thuningxu/my-chip/README.md

# my-chip

A hill-climbing project on matrix-multiply hardware, using open-source EDA
(Yosys + OpenROAD via ORFS) on the Nangate45 academic PDK.

The deliverable is **not** the chip. It is `EXPERIMENTS.md` — a table of
measured, reproducible rows where every row is one idea, and every number says
what kind of number it is.

Four designs live here, selected with `DESIGN=`:

| design | what | scale |
|---|---|---|
| **`mac_array`** (default) | INT4 outer-product MAC array. The v0 baseline, deliberately the simplest *correct* design. `D = init + A@B` with three init modes and two readout modes | 16 mult at N=4, 256 at N=16 |
| **`amx_tdpbssd`** | **Intel AMX `TDPBSSD`** — INT8 tile dot-product, `C += A@B` on `(16,64)@(64,16)`, 16,384 MACs, with optional INT32 saturation | 1024 mult, 16 cycles |
| **`tpu_mmu`** | **TPU v1-style weight-stationary systolic array** — `C += A@W`, N×N, INT8. Built at `TN=32` because 32×32 = 1024 multipliers is *exactly* `amx_tdpbssd`'s count, which makes systolic-vs-broadcast a controlled comparison rather than one across scales | 1024 mult at TN=32, 3N cycles |
| **`amx_fp8`** | **Intel AMX-FP8** (Diamond Rapids) — all four mix-and-match variants (`TDPBF8PS`/`TDPBHF8PS`/`TDPHBF8PS`/`TDPHF8PS`) in one netlist, selected at *runtime* by `op[1:0]`. `C += A@B` on `(16,64)@(64,16)`, fp8 in, **IEEE FP32 accumulate**. Same operand delivery as `amx_tdpbssd`, so the delta is purely the arithmetic. `PIPE=1` registers the product to get the operand mux and the multiply out of the accumulate loop | 1024 mult + **1024 FP32 adders**, 20+`PIPE` cycles |

```bash
make sim-matrix                          # all designs, all parameter states (46)
make measure DESIGN=amx_tdpbssd SAT=1    # synth + P&R one of them
make measure DESIGN=tpu_mmu TN=32 RDREG=1
make measure DESIGN=amx_fp8 RDREG=1 PIPE=1
```

## Prerequisites

| Dependency | Why | Minimum |
|---|---|---|
| Homebrew + Xcode CLT | installing everything else (macOS) | — |
| **Icarus Verilog** | simulation. `measure.sh` refuses to emit PPA without a passing sim | 12.0 |
| **Python 3** | golden model, QoR extraction | 3.8 |
| **Yosys** | synthesis | **0.58** (ORFS minimum) |
| **ORFS** with a built `openroad` | synthesis + place & route + STA | any recent — **see [SETUP.md](SETUP.md)** |
| **KLayout** | GDS merge — and ORFS calls `klayout -v` at makefile **parse** time | 0.28.8 |
| Nangate45 PDK | the standard cells; ships inside ORFS | — |

## Quick start

**On a brand-new machine, start with [SETUP.md](SETUP.md)** — it covers cloning
and building ORFS, which `setup.sh` requires but does not do. On macOS that is
the bulk of the work: ORFS's own `build_openroad.sh --local` does not work there,
and SETUP.md has the manual recipe.

Once ORFS exists and `openroad` runs:

```bash
./setup.sh          # check + install what's missing, write local.mk
make sim            # run the regression       (22/22 must pass)
make measure        # sim-gated synth + P&R, prints one QoR row
make path           # why the clock is what it is
```

`setup.sh` discovers ORFS automatically (`$ORFS`, `../OpenROAD-flow-scripts`,
`~/sd/...`), verifies the `openroad` binary actually runs, checks the Yosys
version against ORFS's 0.58 floor, and resolves a KLayout that **provably
answers `-v`** — auto-creating a de-quarantined copy on macOS if the
`/Applications` one hangs. It writes `local.mk` so no target needs exported
variables. Use `./setup.sh --check` to verify without installing anything.

```bash
make help                       # all targets + resolved tool paths
make sim N=8                    # regression at another array size
make sim-all                    # N = 4, 8, 16
make sim-matrix                 # N x C_PORT x OUT_PAR -- all 12 configurations
make sim OUTPAR=1               # parallel readout: 8 cycles instead of 23
make golden                     # Python reference model
make measure N=8 PERIOD=1.4     # override anything
make sweep-period               # 1.6 / 1.4 / 1.2 / 1.0 ns
make sweep-n                    # N = 4, 8, 16
make clean                      # local artifacts (ORFS results untouched)
```

**`measure.sh` will not produce a PPA number unless the regression passes.**
That gate is the point of the script.

## Layout

```
my-chip/
├── setup.sh             # dependency check/install -> writes local.mk
├── Makefile             # sim / measure / sweep / clean targets
├── local.mk             # generated, gitignored, machine-specific tool paths
├── rtl/mac_array.v      # v0 baseline: parameterised N x N INT4 outer-product MAC
├── rtl/amx_tdpbssd.v    # Intel AMX TDPBSSD, 1024 INT8 MACs, broadcast array
├── rtl/tpu_mmu.v        # TPU v1-style weight-stationary systolic array
├── rtl/amx_fp8.v        # Intel AMX-FP8, all four variants in one netlist
├── rtl/fp8_mul.v        # fp8_dec + fp8_mul -- E5M2/E4M3 decode, exact 4x4 product
├── rtl/fp32_add.v       # IEEE FP32 adder, RNE + DAZ/FTZ. 1024 instances, THE floor
├── tb/tb_mac_array.v    # self-checking regression, 22 cases, PASS at N=4/8/16
├── tb/tb_fp32_add.v     # 121k checks on the adder -- ties, cancellation, DAZ/FTZ
├── tb/tb_fp8_mul.v      # EXHAUSTIVE: all 4 format pairs x 256 x 256
├── tb/golden.py         # independent Python reference + accumulator-width checker
├── tb/amx_golden.py     # 4th model for TDPBSSD: VNNI pack/unpack, both SAT modes
├── tb/tpu_golden.py     # cycle-accurate systolic model + the SCHEDULE PROOF
├── tb/fp8_golden.py     # two independent FP32 adders + an exact rational yardstick
├── flow/nangate45/
│   ├── config.mk.in     # ORFS config TEMPLATE -- the single definition
│   └── constraint.sdc.in# SDC TEMPLATE. Edit these; never the generated copies.
├── scripts/measure.sh   # sim gate -> stage -> ORFS -> QoR row
├── EXPERIMENTS.md       # the log. This is the actual output of the project.
└── work/                # ALL generated output, gitignored
    ├── designs/         #   generated per-N config.mk + constraint.sdc
    ├── results/         #   .odb / .def / .gds / netlists
    ├── reports/         #   layout images (*.webp), DRC report
    ├── logs/            #   per-stage logs + 6_report.json metrics
    └── objects/
```

### Nothing is written into the ORFS checkout

`measure.sh` passes ORFS two variables so the third-party clone stays pristine
and this repo owns its own artifacts:

| Variable | Set to | Effect |
|---|---|---|
| `WORK_HOME` | `my-chip/work` | redirects `LOG_DIR`, `OBJECTS_DIR`, `REPORTS_DIR`, `RESULTS_DIR` (`variables.mk:46-49`) |
| `DESIGN_HOME` | `my-chip/work/designs` | relocates the design tree (`variables.mk:13`) |

ORFS defaults `WORK_HOME ?= .` (`Makefile:98`), which is `$ORFS/flow` when you
run make from there — that is why an unconfigured flow scatters your results
across someone else's repo, where `git clean` or an ORFS update will eat them.
`VERILOG_FILES` points straight at this repo's `rtl/`, so the RTL is never
copied either.

Verified: relocating produced a byte-identical QoR row, and
`$ORFS/flow/{results,logs,reports,objects,designs}` contain no `my_chip_*`
entries.

## What the design computes

**Two names, one convention.** `A`/`B` are the mathematical matrices, indexed
`[row][col]`. `Amem`/`Bmem` are what the two memories hold, indexed `[k][lane]` —
literally what `act_rdata` and `wgt_rdata` deliver, one word of `N` signed INT4
lanes per `k`. The required layout is:

| | holds | so | |
|---|---|---|---|
| `Amem[k]` | **column** k of A | `Amem = Aᵀ` | **A is stored transposed** |
| `Bmem[k]` | **row** k of B | `Bmem = B` | B is not |

In terms of what the ports see, and then what it means:

```
D[i][j] = init[i][j] + sum over k of  Amem[k][i] * Bmem[k][j]   for k in [0, k_dim)
        = init[i][j] + sum over k of     A[i][k] *    B[k][j]
   D    = init + A@B
```

`init` is selected by `init_mode`: `INIT_ZERO` (D = A@B), `INIT_C`
(D = A@B + C, C supplied on `c_in`), or `INIT_KEEP` (D = A@B + D_prev, which
chains k-tiles with no reset). Verified against a textbook triple loop in tb
cases M1/M2.

**Why only A is transposed, and why that isn't a design choice.** In
`C[i][j] = Σ_k A[i][k]·B[k][j]` the contraction index `k` is A's *column* index
and B's *row* index, so any dataflow iterating over `k` must walk A column-wise
and B row-wise. The asymmetry is in the definition of matrix multiplication, not
in this implementation. What varies is which slices you take — an inner-product
array takes row `i` of A against column `j` of B per output; this one is
outer-product, taking column `k` of A against row `k` of B per *cycle* and
accumulating a rank-1 update, `A@B = Σ_k (col_k A)(row_k B)`. That is why one
cycle touches all `N²` accumulators instead of finishing one output.

So there is no transpose *hardware* — the transpose is **relocated** to whoever
fills the memories, where gathering `Amem[k]` is a strided read of A and
`Bmem[k]` is contiguous. Free in gates, not free in data prep.

Measured cost of the addend (yosys generic synth, N=4, total cells): chaining is
free (4937 -> 4935), external C costs +381 cells and is entirely the data mux
(one ACC_W-wide 2:1 mux per accumulator). Build with `C_PORT=0` to drop it.

`A[k]` and `B[k]` are each `N` signed INT4 lanes packed into one memory word.
The block masters two read ports and one write port. `N` is a parameter (power
of two) — sweep it with `measure.sh -n`.

**How results come out is a parameter too, and it decides the cycle count.**
`OUT_PAR=0` (default) drains one element per cycle through an `N*N:1` mux;
`OUT_PAR=1` presents all `N*N` accumulators at once on `out_all`. Measured cycle
counts fit exactly across 20 cases with K from 0 to 2048:

| | cycles | K=4, N=4 | K=1024, N=4 |
|---|---|---|---|
| `OUT_PAR=0` | `K + N*N + 3` | 23 (17% of multipliers busy) | 1043 (98%) |
| `OUT_PAR=1` | `K + 4` | **8 (50%)** | 1028 (98%) |

The drain is a *fixed* cost, so it is nearly free when streaming long K and
catastrophic on the small tile a tensor core is defined by. Because it scales as
`N*N`, the speedup grows with the array: at K=4 it is 2.9× at N=4, 8.9× at N=8
and **32.9× at N=16** (263 → 8 cycles).

In *generic* synth `OUT_PAR=1` looks cheaper — −911 cells, since the serial drain
is not just a mux but two counters, an index multiply-add and an address decode,
all to move data `out_all` reaches with plain wires. **Routed, it costs +99 to
+164 stdcells instead**, because a 384-bit output port needs ~382 buffers that
generic synth does not model. The flip-flop saving is real and exact (−33), and
cell *area* does fall (−74 to −182 µm²) since flops are bigger than buffers.
Coarse-cell deltas tell you about logic, never about area — see `EXPERIMENTS.md`
rows f2a/f2b, where the same trap caught `c_in` in the other direction.

Both modes are permanent: `out_all` is `N*N*ACC_W` bits, 384 at N=4 but
**6,144 at N=16**, so the parallel readout is viable *because* a tensor-core tile
is small. Keep the serial drain for large-N streaming.

v0 is deliberately the **simplest correct** design, not a fast one: multiply and
a full 24-bit add sit in the same cycle. That is the first thing to fix, and the
baseline you measure against.

## Discipline this repo enforces

Each of these exists because its absence caused a real, documented failure in a
prior project of this kind:

| Rule | Failure it prevents |
|---|---|
| `measure.sh` gates PPA on a passing sim | a published headline frequency for a design that computed `2*sum - last` instead of a dot product, because *it was never simulated* |
| T1 (all-ones, K=4) is permanent | that same double-accumulate bug — it shows up as `5` (or `7`) instead of `4` |
| T6 (restart with no reset) is permanent | `DONE` as a terminal state: first operation works, every later `start` silently ignored |
| T5 (adversarial K) + `golden.py --acc-w` | a 12-bit accumulator claimed safe to K=64 that actually overflows at K=32 |
| The config exists once, as a template `measure.sh` fills in | nearly every config in a comparable project hardcoded its author's home directory, unrunnable anywhere else — and a committed config nothing reads will silently drift from the one that runs |
| `measure.sh` verifies a **GDS** exists, not just metrics | reporting PPA for a flow that never finished. ORFS lists `6_report.log` before `$(GDS_FINAL_FILE)` in `finish`, so an image-renderer crash (GUI-0070) aborts make *before* the GDS rule — for many runs this repo reported routed numbers for a design it had never actually built |
| SDC always sets `set_clock_uncertainty` | omitting it flatters every reported frequency by ~10% |
| `EXPERIMENTS.md` has a `Stage` column | an ABC mapping objective (900 MHz) tabulated next to routed slack as if comparable |
| Baseline measured in *this* flow | speedups quoted against an external number that was never reproduced |
| `N` is a parameter | dozens of near-duplicate hand-copied RTL files, one per array size |
| The tb **asserts** cycle count, not just the result | an optimisation that quietly *cost* cycles while still computing the right answer. `OUT_PAR` exists to move that number, so leaving it unchecked would make the whole change unfalsifiable |
| `make sim-matrix` builds every parameter in both states | a parameter that only ever ships in one configuration is dead code with a name — `C_PORT=0` and `OUT_PAR=1` each have to compile, simulate and route |
| `nick()` is the single definition of an artifact name | `make path` reading a *different design* than `make measure` just wrote, reporting a plausible wrong critical path. Adding `OUT_PAR` to the name needed an explicit `!= "0"` test, because `${4:+...}` fires on the string `"0"` and would have renamed every existing config |

## Known gotchas already hit

- **Do not declare an output port `signed`.** Yosys preserves the attribute into
  the netlist and OpenSTA rejects it (`syntax error` on the port line). Bits are
  two's complement regardless.
- **`klayout -v` runs at makefile-parse time.** Every `make` invocation hangs if
  KLayout is quarantined. On macOS: `ditto --noextattr --norsrc` a copy, or clear
  `com.apple.quarantine`.
- **A variable-indexed 2D array read is an `N*N:1` mux.** Fine at N=4 and N=16
  (both measured; neither is limited by it), becomes the critical path around
  N=32. Pipeline the readout before scaling that far.
- **ORFS's `6_report` can fail at `GUI-0070`** (`gui::save_image` cannot find a
  display control) *after* metrics are already written. That is the image
  renderer, not the design — 9 of the 10 layout images are still produced, only
  `final_worst_path.webp` is lost. `measure.sh` tolerates that exact signature
  and hard-fails on anything else.
- **`read_db` does not restore liberty.** Load `read_liberty` first or STA gives
  you nothing but `STA-2141 No liberty libraries found`.
- **`report_checks` defaults to the worst path group**, which here is an
  asynchronous recovery check on `rst_n` — true, but a false path in the SDC and
  useless for finding the datapath limiter. Always pass `-path_group core_clock`
  (`scripts/report_path.sh` does).

## License

MIT — see [LICENSE](LICENSE).

Covers the contents of this repository only: the RTL, testbench, scripts,
templates and docs, all of which are original. It does **not** cover the tools
this project drives or the PDK it targets, none of which are vendored here:

| Not covered | Licensed separately |
|---|---|
| OpenROAD / ORFS | BSD-3-Clause |
| Yosys | ISC |
| Nangate45 PDK | its own terms — ships inside ORFS |
| Icarus Verilog | GPL-2.0 |

## Honest scope

Nangate45 is a teaching PDK with no fab target, and `measure.sh` reports the
**typical** corner only, with no signoff derating. These numbers are useful for
comparing rows in `EXPERIMENTS.md` against each other. They are not silicon
predictions, and they are not comparable to a production accelerator on a modern
node.

## Current state

All four designs are routed and DRC-clean. Frequencies are `reg→reg` — the only
kind this project compares, because a path ending at an output port is measuring the
SDC's pad convention rather than the hardware.

| design | best measured | notes |
|---|---|---|
| `mac_array` | 783 MHz at N=4, 748 at N=16 | v0 baseline. Setup not met at 1.00 ns; multiply and a 24-bit add share a cycle |
| `amx_tdpbssd` | **698.9 MHz / 2.436 W** at `PIPE=3 RD_REG=1` | X1–X4 **closed**. Limited by a multiplier carry-propagate at ~703 MHz; 1.40 ns is the knee, past which power is the cost and frequency is not the return |
| `tpu_mmu` | 3N cycles at `TN=32` | one row, systolic-vs-broadcast at matched multiplier count. **Hold is violated — not signoff-clean**, `--hold-margin` was omitted |
| `amx_fp8` | **210.5 GMAC/s**, 256.9 MHz / 14.45 W at `PIPE=1 RD_REG=1 CTRL_REG=1 CHAIN=1` | X5–X7. **+45.5%** completed throughput over X5-Y0, at initiation interval 20 and latency 20. Hold passes and DRC=0, but setup misses 3.80 ns by 92 ps; clock and throughput are STA-implied, not timing-closed |

The comparison this project exists to make: **bit-exact IEEE FP32 accumulation
costs 2.72× the throughput and 6.02× the cells of INT32 accumulation** at
identical MAC count and operand delivery. That penalty has fallen twice —
3.99×/7.48× at X5-Y0, 3.45×/6.49× after `PIPE=1`, 2.72×/6.02× after the epilogue
control register and the chained handshake. None of it came from touching the FP32
arithmetic.

Ranked on **completed resident-tile throughput**, not MHz, and the distinction
earned its keep: X7's `CHAIN` moved the clock +0.08% and throughput **+5.094%**, by
cutting the initiation interval from 21 to 20 cycles. An MHz-ranked hillclimb would
have discarded it as flat. Cycle counts differ between the designs (20 vs 21 before
`CHAIN`), so the throughput ratio is not the frequency ratio — see the correction in
`EXPERIMENTS.md`.

**One caveat on the INT8 anchor.** The 698.9 MHz figure above was measured with a
reg→reg STA query that was corrected during X6; it could admit an input-port launch,
and its routed database has since been deleted, so it is labelled rather than
re-derived. Every ratio in this section inherits that and should be read as
approximate. The `amx_fp8` rows are all post-fix and unaffected. Details in
`experiments/harness.md`.

Two campaigns of reasoning are logged separately from the rows:
`experiments/harness.md` declares each generation *before* its trials run, and
`experiments/RESULTS.md` tabulates them. `rtl/README.md` carries the measured
critical paths.
