thuningxu/my-chip/(commit log)

2026-08-28 INT4 MAC array hill-climbing project with a sim-gated measurement harness
    A parameterised N x N signed INT4 outer-product MAC array, plus the
    infrastructure to measure it honestly through Yosys + OpenROAD (ORFS) on the
    Nangate45 academic PDK.
    The deliverable is EXPERIMENTS.md -- a table of measured, reproducible rows,
    one idea per row, where every number states what kind of number it is.
    v0 is deliberately the simplest CORRECT design rather than a fast one: multiply
    and a full 24-bit add share one cycle, so there is somewhere to climb from. N is
    a parameter from the start rather than a hand-copied file per array size.
    Measured baseline (ORFS 26Q3-1510, nangate45, typical corner, both DRC-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
    [golden.py, mac_array.v, tb_mac_array.v]
2026-08-29 Add the +C addend (D = A@B + C), and the tooling to prove it
    Three strands, all measured rather than asserted.
    1. THE ADDEND. mac_array gains init_mode, selecting what the accumulators
    start from:
    INIT_ZERO D = A@B bit-identical to v0 (encoding 0, so an
    undriven port reproduces the old design)
    INIT_KEEP D = A@B + D_prev chains k-tiles, costs -2 cells
    INIT_C D = A@B + C arbitrary external C on an N*N*ACC_W port
    Also verified that the UNMODIFIED datapath already computes a matrix
    product when A is fed column-major -- no transpose hardware was needed,
    only a statement of the memory layout. Checked against an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
2026-08-29 Name the two coordinate systems: A/B vs Amem/Bmem
    "A" was being used to mean two different things, four lines apart in the same
    header, and the ambiguity had spread to five files. rtl/mac_array.v:5 wrote
    D[i][j] = sum_k A[k][i] * B[k][j]
    where "A" is the STORED array (so that expression is A-transpose times B), then
    nine lines later wrote "word k holding column k of A (lane i = A[i][k])" where
    "A" is the MATHEMATICAL matrix. golden.py picked the first convention and printed
    "C = A^T B"; README.md:107 and EXPERIMENTS.md:157 used the first, README.md:113
    the second, and rtl/README.md the first. Every one self-consistent; together,
    confusing -- and in matmul hardware a misread of which ob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
2026-08-29 Schematics: per-config output directories, and draw amx_tdpbssd too
    Two fixes, both prompted by the same observation -- that every schematic run
    wrote to one flat build/schematic/.
    1. OUTPUT IS NOW PER-CONFIGURATION, at build/schematic/<nick>/, reusing the same
    nickname the measured artifacts use so a figure set can be matched to an
    EXPERIMENTS.md row.
    The flat directory was a real defect, not a cosmetic one: `make schematic
    CPORT=0` silently overwrote the CPORT=1 set, and SN=4 overwrote SN=2, with
    nothing but the caption to say it had happened. I had added those captions
    AS the mitigation and left the collision in place. A caption is a mitigation;
    a distinct path is t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
2026-08-29 X-Y hillclimb harness + PIPE ladder, and a test gap the mutations exposed
    Sets up the Meta-Harness style outer loop for amx_tdpbssd, with Claude Code as
    the only harness. X = harness generation (how the design is reasoned about:
    which reports get read, which bottleneck gets blamed, which family of fix gets
    proposed). Y = an RTL attempt inside that generation. A Y failing implicates the
    DESIGN; a whole X row going flat implicates the HARNESS, because it kept
    proposing from the wrong family. X advances when Y stops moving.
    INFRASTRUCTURE
    experiments/harness.md append-only. X1 declared BEFORE any RTL was touched,
    including what it CANNOT reach so a plateau is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
    [amx_tdpbssd.v, tb_amx_tdpbssd.v]
2026-08-29 Add the X-Y grid reader, and fix its flat-row diagnostic
    scripts/trials.py prints the grid from experiments/trials.jsonl with the delta
    between consecutive Y, because the decision the two-axis scheme exists to support
    cannot be made from one row:
    a Y regressing or failing -> the DESIGN is wrong, try another Y
    an entire X row going FLAT -> the HARNESS is wrong; it kept proposing from
    the wrong family, so more Y cannot help
    Like trial.sh, it decides nothing. "Flat" is a threshold on a number; whether
    that means the generation is exhausted is a judgement to be made next to what
    that generation declared it could and could NOT reach.
    FLAT_MHZ is 10.0,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
2026-08-29 trial.sh: assert predictions instead of logging numbers beside them
    Acting on the second-order lesson from the X1-Y1 drift bug. The flop count was
    already being recorded, the prediction (+4,608 flops for PIPE=1) was already
    written down in the goal string, and nothing compared them -- so a trial that
    built the wrong hardware ran for 17 minutes and was about to be logged as a
    result.
    --expect-flops N now checks the SYNTHESISED netlist against the prediction. On a
    mismatch the trial's result is demoted to OK_BUT_WRONG_HARDWARE and the mismatch
    is appended to the record's bugs list, because the PPA numbers in that case are
    real but do not describe the change the trial claims to be testing. Tha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
2026-08-29 Record FLW-0009 calibration: optimistic by ~0.032 ns on a 1.55 mm die
    X1 declared FLW-0009 as the slack report, cross-validated on mac_array f2b where
    it matched the routed value to 0.001 ns. It does not hold on amx_tdpbssd:
    mac_array f2b 156 um die -0.2590 -> -0.2581 +0.0009
    amx a1 1555 um die -1.7850 -> -1.8171 -0.0321
    amx X1-Y0 1554 um die -0.0240 -> -0.0565 -0.0325
    Consistently about -0.032 ns on the large die and nil on the small one: detailed
    routing adding wire delay that global-route parasitics underestimate, scaling with
    distance. FLW-0009 is still the right thing to read DURING a run -- it is the
    design's worst path, unlike an optimizer's progress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
2026-08-30 Declare X2: X1's fix family was right, its measurement was blind
    X1 is superseded, not abandoned. The path report proves its fix family worked:
    X1-Y1's worst path now ends at s4r, the register PIPE=1 created, so the accumulate
    loop is no longer critical and X1's declared floor was never reached. The
    feed-forward stage is still longest, which is precisely what PIPE=2 targets.
    What failed is X1's MEASUREMENT PROCEDURE, which is a harness fault by definition.
    WNS was unchanged between Y0 and Y1 (-0.057 vs -0.054) for a path that is
    LOGICALLY SHORTER, because the tool relaxed it: TNS -35.958 -> -0.763, violating
    endpoints 2812 -> 41, and 51,786 buffer cells consequently never inserted. A fixed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
2026-08-30 trials.py: group ladder economics by RTL variant, not by trial
    Added a cost-per-gain view because the X-Y grid answers "is this row still moving"
    and not "is the movement worth what it cost" -- which on this design is the
    sharper question, since PIPE=1 spends 4,608 flops for its stage and PIPE=2 spends
    16,384 for the next.
    The first version grouped per TRIAL and its own output showed that to be wrong: it
    split PIPE=1's gain across two rows, "+0.3 MHz for +4,610 flops" at the saturated
    2.80 ns target and then "+54.4 MHz for +0 flops" when the same RTL was re-measured
    at 2.00, making one change look worthless and then free. Neither is true.
    A trial measures an (RTL, target) PAIR, and a satur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
2026-08-31 Make the trials.jsonl append lock-safe, and run trials in parallel
    Parallelism is worth much more here than the core count suggests, because most of
    an ORFS run is SINGLE-THREADED. Measured on this machine (18 logical cores, 6P+12E,
    24 GB):
    yosys synthesis 100% CPU (one core) ~8 min
    global route + repair_timing ~110% CPU ~15 min
    detailed route 1682% CPU (~17 cores) ~10 min
    So for roughly two thirds of the wall clock, 17 of 18 cores are idle. Two
    concurrent trials overlap their serial phases almost for free and only contend
    during detailed routing.
    Isolation was already sound and was verified rather than assumed: nothing is
    written into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
2026-08-31 trials.py: distinguish a SATURATED step from a FLAT one
    The grid was reading X1's row as "still moving (+0.3 MHz)" -- technically true and
    substantively backwards, since that +0.3 was the saturation artifact concealing a
    15.6% gain. Under the X-Y rule a flat row implicates the FIX FAMILY, so reporting
    saturation as flatness blames the design for the period's fault. That is the exact
    misdiagnosis the X1 row invited and which cost a manual investigation to unpick.
    The grid now checks saturation BEFORE flatness: |TNS| < 5.0 means the tool met its
    target and stopped working, so the trial measures the target rather than the
    design. Threshold calibrated from real rows -- X1-Y1 was saturated at -0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
2026-08-31 Measure the routed cost of saturation: 23x the coarse-synth prediction
    Open since SAT was introduced, now measured one variable apart (PIPE=1, 2.00 ns
    target, everything else identical), run in parallel with the ladder trials on
    otherwise-idle cores.
    SAT=0 SAT=1 delta
    setup WS ns -0.5367 -0.4702 +0.0664
    setup TNS -1242.9 -1067.8 +175.1
    implied fmax 394.2 404.8 +10.6
    stdcells 474810 492398 +17588
    flip-flops 29194 29194 0
    area um2 958398 971277 +12879
    Saturation costs AREA, not state and not speed. Zero flops, as expected: the clamp
    is pure combinational logic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
2026-08-31 X2-Y1: PIPE=2 reaches 482.7 MHz (+37.9% cumulative), and my prediction was wrong
    PIPE best at fmax d fmax flops d flops MHz per 1k flops
    0 X1Y0 350.1 - 24584 -
    1 X2Y0 404.8 +54.7 29194 +4610 +11.87
    2 X2Y1 482.7 +77.9 45579 +16385 +4.75
    Hold met (+0.0353, 0 viol), DRC clean, flop prediction exact at 45,579.
    THE PREDICTION IN THE GOAL STRING WAS WRONG. It said "the multiply still dominates
    the split so the gain should be smaller than PIPE=1's +54.7 MHz". The gain is
    LARGER, +77.9. So the adder tree was a bigger fraction of that stage than assumed:
    an 8x8 multiply is ~407 gates against a 4-input tree of ~250, and depth is
    evi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
2026-08-31 X2-Y3 calibration: every fmax in this project is a lower bound
    Same PIPE=2 RTL, two targets:
    target 1.80 -> WS -0.2717 need 2.0717 fmax 482.7 TNS -906 cells 577348
    target 1.50 -> WS -0.4788 need 1.9788 fmax 505.4 TNS -3550 cells 583132
    +22.7 MHz for 5,784 cells, from identical Verilog. PIPE=2 was EFFORT-limited, not
    design-limited -- and crucially it was NOT saturated (TNS -906), so the |TNS| < 5
    saturation test does not catch this. It is a second, distinct failure mode:
    saturated |TNS| small; tool met the target and stopped -> tighten
    effort-limited TNS large and negative, yet tightening STILL -> tighten more,
    improves it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
2026-08-31 X2-Y4: retract the "+28 MHz/1k flops" claim -- it compared against a floor
    PIPE=3 at 1.60: 514.9 MHz, needs 1.942 (was 511.4 / 1.955 at a 1.80 target).
    The two variants turn out to have been effort-limited by very different amounts:
    PIPE=2 tightening 1.80 -> 1.50 +22.7 MHz
    PIPE=3 tightening 1.80 -> 1.60 + 3.5 MHz
    PIPE=2 was heavily effort-limited, PIPE=3 barely. Mechanism: the more pipelined the
    design, the less optimisation headroom is left in its already-short stages, so a
    given target lands nearer the true limit. Effort-limitation is therefore NOT a
    uniform offset -- it shrinks as the design improves, so it cannot be corrected with
    a constant and has to be measured per vari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
2026-08-31 Declare X3 and add RD_REG: register the readback port
    X3 is declared from measurement, not from X2's stated ceiling. Both X3 candidates
    reasoned out in advance -- a physical/floorplanning generation, or an internal split
    of the 8x8 multiply -- were WRONG. X2-Y4's worst path is neither:
    a_flat[2420]/CK <- clock network delay 0.717
    a_flat[2420]/Q -> MUX2 x4 -> BUF x2 -> MUX2 -> NOR2 -> AOI21 -> BUF -> rd_data[372]
    arrival 1.522 slack -0.342
    It is the tile READ port, and 47% of the arrival is clock insertion delay that DOES
    NOT CANCEL, because the path ends at an output port: with no capture flop the
    capture side contributes 0.000 clock network delay, so the 0.717 launch delay is
    pur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
    [amx_tdpbssd.v, tb_amx_tdpbssd.v]
2026-08-31 X3-Y0: RD_REG=1 reaches 620.8 MHz -- and exposes a defect in the metric
    The trial: registering rd_data on top of PIPE=3, same 1.60 ns target as X2-Y4,
    one variable. Flop prediction was exact (47,116 predicted, 47,116 built).
    setup WS -0.3422 -> -0.0108 TNS -114.64 -> -0.013 (8900x)
    fmax 514.9 -> 620.8 MHz cells +3,639 (+0.7%), flops +512
    area -930 um2 power -0.118 W hold/DRC clean
    Area and power fell while adding 512 flops: the same buffering collapse seen
    at PIPE=3 vs PIPE=2. Removing the readback bottleneck let the tool stop
    over-buffering it.
    WHAT I GOT WRONG: I predicted the worst path would move onto the compute
    datapath. It did not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
2026-08-31 Fix the harness metric: record what is actually limiting each row
    THE DEFECT. constraint.sdc.in budgets I/O as a fraction of the period, so for a
    path ending at an output port the required time is 0.8P - 0.1 and
    implied period = P - ws = 0.2P + 0.1 + arrival
    The 0.2P term shrinks as the target tightens, so 1000/(P-ws) RISES with
    byte-identical hardware: X3-Y0 reads 620.7 MHz at P=1.60 and would read 670.7 at
    P=1.00 with nothing changed. A combinational input->output path is charged
    0.4P + 0.1. Eight trials were logged without ever recording WHERE the limiting
    path ended, so this went unnoticed. The fix family in X3 was right; the
    instrument was not.
    RECOVERED, NOT RE-MEASURED. Every t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
2026-09-01 Close X4: wall at ~703 MHz, operating point 698.9 MHz / 2.436 W
    Three trials, ONE RTL (PIPE=3 RD_REG=1), three targets. 47,116 flops on every
    row -- the guard that nothing drifted.
    target reg->reg fmax d TNS limiter power
    1.60 658.7 - -0.01 sat OUT-PORT 2.098 W
    1.40 698.9 +40.2 -1.56 sat OUT-PORT 2.436 W
    1.20 702.9 +4.0 -558.27 reg->reg 3.069 W
    X4-Y0 REFUTED X4's premise. X4 blamed the multiplier carry chain, but at 1.60 that
    path had +0.0818 ns of SLACK -- never observed to fail, so the blame was
    unfalsified rather than confirmed. Retargeting with no RTL change gained +40.2 MHz:
    the path was effort-limited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
2026-09-01 Add experiments/report.html: readable campaign report, one plate per trial
    Ten routed die plots, each with what the trial changed and what it measured, plus
    the metric correction applied inline: where a row was limited by the pad boundary
    rather than the design, the originally reported frequency is struck through and the
    register-to-register figure shown beside it.
    scripts/report.py generates it. Prose is authored in the script; every number comes
    from trials.jsonl and every image from the routed reports, so no figure is hand-typed.
    Images are inlined as base64, which is why the generated HTML is committed too:
    work/ is build output and not in git, so the report is not regenerable once it i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
2026-09-01 Add datapath block diagrams, one per RTL variant
    Five designs, same chain: tiles -> 16:1 mux -> 8x8 multiply -> adder tree ->
    33-bit add + saturating fold -> cacc, plus the readback mux out to the port. What
    each pipeline level changes is only WHERE a register boundary falls, so the
    diagrams draw one fixed datapath and light up the boundaries that exist at that
    level. Absent boundaries stay visible as dashed outlines, which is what makes the
    ladder legible: the reader sees cuts appear rather than five unrelated pictures.
    Structure was read out of rtl/amx_tdpbssd.v, not from memory, and the flop
    accounting is the check that the diagram matches the built hardware:
    base a_flat 8,192 + b_f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
2026-09-01 Keep one layout in a "Final result" section, drop the other nine
    The per-trial die plots were near-identical: dense routed views at the same die
    size and the same 40% utilisation target, differing in ways the eye cannot
    attribute to anything. Nine of them cost 2.2 MB to say less than the metrics
    tables already say. The final netlist gets one plate of its own instead.
    experiments/img/ 2.50 MB, 10 files -> 0.26 MB, 1 file
    REPORT.md 25.3 KB -> 24.5 KB
    New "Final result" section in both formats: the routed layout of PIPE=3 + RD_REG at
    1.20 ns, with area, cell and flop counts, the limiter, and hold/DRC status.
    It states plainly that this is NOT the recommended operating point.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
2026-09-01 Lead with the final chip and a baseline-vs-final comparison
    The layout now sits in the headline rather than a section at the end, beside a
    table comparing the baseline against the final design:
    Baseline X1-Y0 Final X4-Y0
    Design PIPE=0, one path PIPE=3 + RD_REG
    Clock target 2.80 ns 1.40 ns
    fmax reg->reg 350.1 MHz 698.9 MHz +99.6%
    Power 19.001 W 2.436 W -87.2%, 7.8x less
    Flip-flops 24,584 47,116 +91.7%
    Standard cells 509,176 532,445 +4.6%
    Die area 1,086,640 um2 1,046,050 -3.7%
    Hold / DRC +0.0399 / 0 +0.0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
2026-09-01 Fix the last 'an eighth of the power' in the HTML headline
    The earlier pass replaced three of four occurrences; this one differed by a %%
    escape and slipped through, so the HTML said an eighth while the Markdown said
    7.8x. 2.436/19.001 is 12.8%, an eighth is 12.5%, so 7.8x is the exact figure and
    the only one either format should carry.
2026-09-01 Add throughput accounting: does the arithmetic actually get faster?
    The obvious objection to a pipelining ladder, and the report did not answer it:
    every stage adds a register, so one instruction passes through more clock edges.
    If frequency rose by less than the cycle count did, the design would compute
    more slowly while reporting a higher clock.
    The premise is right. The testbench asserts KDW + 1 + PIPE = 17 + PIPE cycles on
    every run, so the baseline finishes in 17 and the final design needs 20: +17.6%.
    The conclusion inverts, because frequency rose 99.6%.
    variant target fmax cyc latency one-op streamed GMAC/s/W
    PIPE=0 2.80 350.1 17 48.56ns 33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
2026-09-01 Add amx_fp8: Intel AMX-FP8, all four mix-and-match variants
    C[16][16] fp32 += A[16][64] fp8 @ B[64][16] fp8 -- 16,384 MACs in 20 cycles,
    1024 fp8 multipliers and 1024 IEEE FP32 adders. op[1:0] selects the instruction
    at RUNTIME (op[1] = A is HF8, op[0] = B is HF8), so one netlist executes
    TDPBF8PS, TDPBHF8PS, TDPHBF8PS and TDPHF8PS. BF8 = E5M2, HF8 = E4M3.
    WHY: this fixes the defect recorded in the tpu_mmu merge. That comparison moved
    two variables at once (operand delivery AND accumulator placement), so its
    result could not be attributed to either. amx_fp8 reuses amx_tdpbssd's operand
    delivery exactly -- same 16x64 register tiles, same 16:1 B-row mux, same per-row
    16:1 A-dword mux, same k-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
    [amx_fp8.v, fp32_add.v, fp8_golden.py, fp8_mul.v, tb_amx_fp8.v, tb_fp32_add.v, tb_fp8_mul.v]
2026-09-01 Document amx_fp8, and stop yosys's `share` pass from stalling on it
    Docs: README.md and rtl/README.md gain the fourth design; rtl/README.md's
    comparison table becomes three columns and states plainly that tpu_mmu vs
    amx_tdpbssd moved TWO variables while amx_fp8 moves one. tb/README.md gains a
    section on why the FP8 design verifies its leaves before its array, why the array
    testbench legitimately uses those proven leaves as its oracle, and why
    fp8_golden.py's libc-based second adder is sound for a single add (53 >= 2p+2).
    It also reproduces the one number that admits what the ISA does not settle: the
    balanced-tree and sequential epilogue orderings differ on 23% of output elements,
    printed on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
2026-09-01 Keep fp32_add/fp8_mul hierarchical, and drop the `signed` that broke OpenSTA
    SYNTHESIS TIME. amx_fp8 instantiates ONE 1260-cell adder 1024 times, and
    flattening makes ABC optimise 1024 independent copies of identical logic. New
    per-design @SYNTH_HIER@/@SYNTH_KEEP@ tokens set SYNTH_HIERARCHICAL=1 and
    SYNTH_KEEP_MODULES="fp32_add fp8_mul" for amx_fp8 only; the other three designs
    render SYNTH_HIERARCHICAL=0 and an empty keep-list, which is ORFS's own default,
    so they are behaviourally unchanged.
    Measured on this design:
    flattened ~30 min just to REACH abc; 34 min in and still there when killed
    hierarchical whole synthesis in 90 s, 1.72 GB peak
    cost fp32_add 1368.8 -> 13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
    [fp32_add.v, fp8_mul.v]
2026-09-05 Thread PIPE through the fp8 build, and fix `make measure` dropping -P
    measure.sh's amx_fp8 case gains PIPE in TOP_PARAMS, SIM_PARAMS and
    CFG_DESC. All three, because the guard at measure.sh:127 hard-fails if a
    -P handed to the testbench is absent from VERILOG_TOP_PARAMS -- the
    omission that once had the gate simulate PIPE=1 while the flow built
    PIPE=0. Verified in both directions: the guard fires on a deliberate
    mismatch and passes as committed.
    A LATENT BUG, found while doing it: `make measure` never passed -P at
    all, so `make measure PIPE=n` has always built PIPE=0. The drift guard
    structurally cannot catch this -- with no -P both sides agree on the
    default, so the guard is satisfied whil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
2026-09-05 Declare X5: the adder is the floor, everything ahead of it is one register away
    Declared BEFORE its trials ran, which trial.sh enforces by grep. Target
    design changes from amx_tdpbssd, whose campaign closed at X4, to amx_fp8.
    Blames the 2.021 ns of feed-forward ahead of fp32_add on p1's routed path,
    which launches from ccnt: 38% of a 5.373 ns data path is logic sitting in
    front of a loop it does not belong to. Fix family is a cumulative PIPE
    parameter registering the product.
    Ranks POWER alongside fmax, and that is the harness delta rather than a
    footnote. X4 closed by finding a 19.2x power win at constant frequency
    that X1 through X3 could not see, because a hillclimb ranking one scalar
    c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
2026-09-05 X5-Y1: PIPE=1 reaches 212.6 MHz, and falsifies the floor X5 declared
    Rows p2 (PIPE=0) and p3 (PIPE=1), same platform, equal 4.00 ns target, one
    parameter apart, both reg->reg limited, both DRC 0.
    reg->reg fmax 176.5 -> 212.6 MHz +20.5%
    cycles 20 -> 21
    THROUGHPUT 144.6 -> 165.9 GMAC/s +14.7% <- the number
    power 40.2251 -> 14.0894 W -65.0%
    energy 3.59 -> 11.77 GMAC/J 3.28x
    flip-flops 57,867 -> 74,252, predicted 74,252
    +14.7% and not +20.5%: PIPE buys clock with a cycle, and Rule 3 exists so a
    clock gain is never quoted as a throughput gain.
    THE PREDICTION FAILED, and how it failed is the finding. X5 declared a floor
    of 3.692 ns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
2026-09-05 Bring the docs in line with four designs and a floating-point one
    README's "Current state" still said only the v0 baseline was measured, three
    designs and two campaigns ago. It now carries a per-design table of best
    measured reg->reg figures, including tpu_mmu's hold violation, and states the
    comparison the project exists to make: bit-exact FP32 accumulation costs 3.45x
    the throughput and 6.49x the cells of INT32, down from 3.99x and 7.48x.
    EXPERIMENTS.md's Units section opened "There is no floating point anywhere in
    this project", written before amx_fp8 existed. Three of four designs are
    integer; amx_fp8 multiplies fp8 and accumulates in IEEE FP32, so a FLOPS
    figure is meaningful for it --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
2026-09-05 Stop rtl/README.md quoting the leaf number EXPERIMENTS.md repudiated
    The fp32_add module row headlined "1198 cells, ~6.2 ns". That is the
    `abc -liberty` measurement -- 6.180 ns / 1,260 cells -- and EXPERIMENTS.md
    records it as a process failure, not a spec: ORFS maps the same RTL with
    `abc_speed.script` plus upsize/dnsize and gets 2,270 cells at 2.491 ns, so the
    projection built on it was 1.86x low on cells and 2.5x slow on timing, chose a
    7.00 ns target, and cost a thrown-away run. The lesson written down there is
    "benchmark a leaf with the flow's own recipe or not at all" -- and the module
    table was quoting the number that lesson exists to retire.
    Now carries the flow-recipe figure and th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
2026-09-12 Add CTRL_REG and CHAIN to amx_fp8: local epilogue control, chained launch
    CTRL_REG=1 predecodes the NEXT epilogue phase and registers three control bits
    per output cell -- 768 flops across 256 cells -- using them for both operand
    selection and epilogue writes. Because it registers ep_next (EP0/1/2 minus one)
    rather than the current phase, control is retimed without shifting the schedule:
    21 cycles stays 21. The (* keep = 1 *) attribute is load-bearing: 256 identical
    drivers merge without it, and a kept wire name does not prevent that -- only a
    kept register does. scripts/check_control_regs.py verifies the 768 survived
    mapping by inspecting actual Q connections, not instance names.
    CHAIN=1 a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
    [amx_fp8.v, tb_amx_fp8.v]
2026-09-12 Plumb CTRL_REG/CHAIN, and add the launchers, replica gate and throughput ranking
    measure.sh and the Makefile thread both new parameters, and TOP_PARAMS gains them
    alongside SIM_PARAMS so the drift guard at measure.sh:127 still proves the gate
    tested what the flow built. sim-matrix sweeps all sixteen
    PIPE/RD_REG/CTRL_REG/CHAIN combinations: 34 configurations to 46.
    trial.sh and trials.py record and rank COMPLETED throughput -- measured
    initiation interval, completion latency, and GMAC/s -- not MHz. Rows without a
    measured interval are omitted from the ranking rather than silently backfilled
    from a latency figure they never established. `trials.py --throughput` prints the
    resident-tile rankin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
    [test_x6_harness.py]
2026-09-12 X6/X7: +45.5% completed throughput, and one row MHz could not see
    Six trials, all reg->reg limited, all with GDS and empty DRC reports, all with
    hold met. Rows p4-p9 in EXPERIMENTS.md.
    X6 changed the OBJECTIVE before running its own trials: completed resident-tile
    GMAC/s = 16384 * fmax / (1000 * initiation_interval), with the interval measured
    by consecutive operations rather than inferred from single-operation latency.
    Then registered the epilogue control per cell.
    X6-Y0/Y1 CTRL_REG 0->1 4.00 ns 171.113 -> 193.428 GMAC/s +13.04%
    X6-Y2/Y3 target sweep 3.80/3.60 199.992 / 200.208 GMAC/s
    X7-Y0/Y1 CHAIN 0->1 3.80 ns 200.265 -> 210.467 GMAC/s +5.094%
    X6's startpoint pr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
